b-buckley/blinker-vest/images/enclosure/tinkercad/box-design_1_negative-volume_th.png

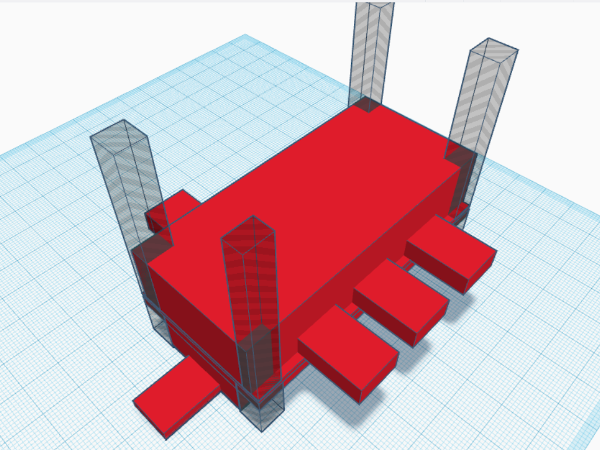
images/enclosure/tinkercad/box-design_1_negative-volume_th.png
