b-buckley/blinker-vest/images/enclosure/box-2_resizing-fuse-holes_th.jpg

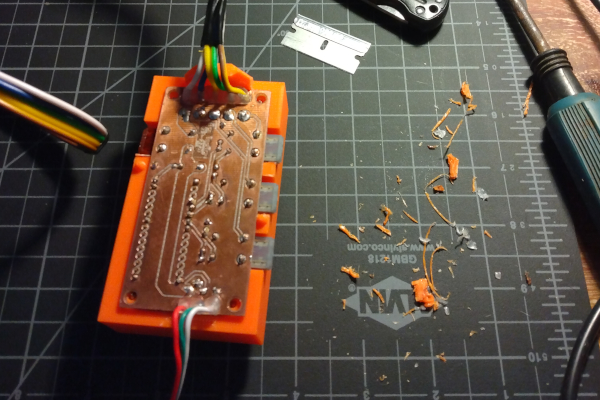
images/enclosure/box-2_resizing-fuse-holes_th.jpg
