b-buckley/blinker-vest/images/enclosure/box-4_finished-bottom_th.jpg

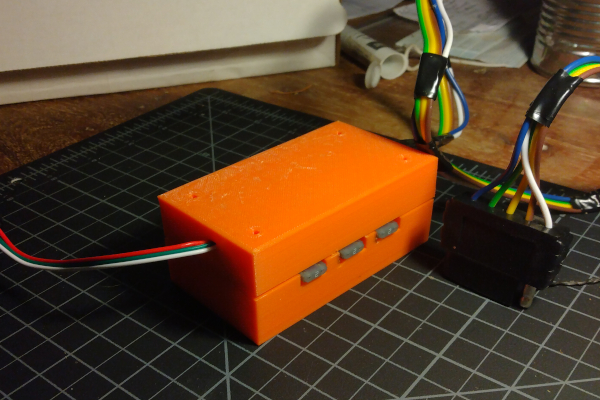
images/enclosure/box-4_finished-bottom_th.jpg
