b-buckley/blinker-vest/images/enclosure/box-5_finished-top_screw-holes_th.jpg

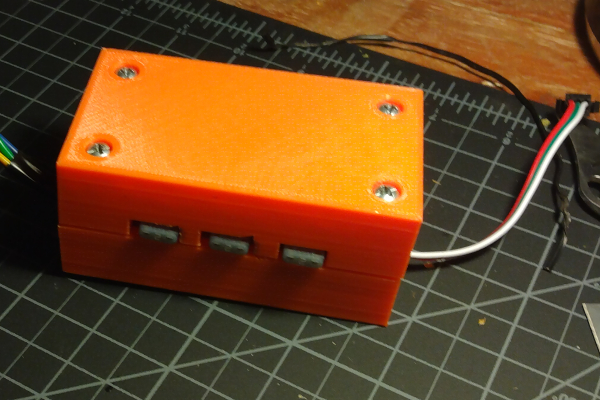
images/enclosure/box-5_finished-top_screw-holes_th.jpg
