b-buckley/blinker-vest/images/enclosure/tinkercad/box-design_2_solid-box.png

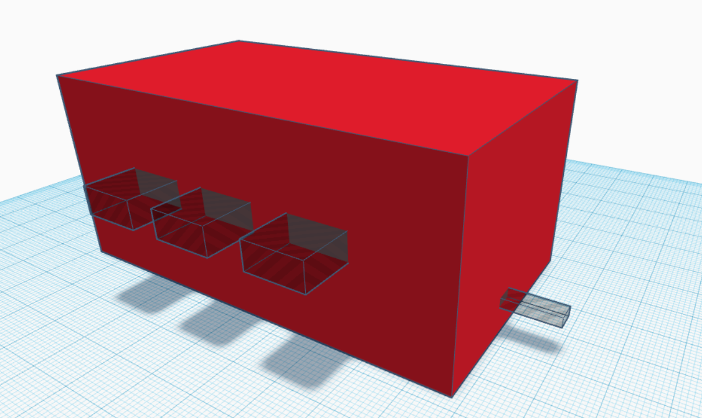
images/enclosure/tinkercad/box-design_2_solid-box.png
