b-buckley/blinker-vest/images/enclosure/tinkercad/box-design_3_tabs-cut-out.png

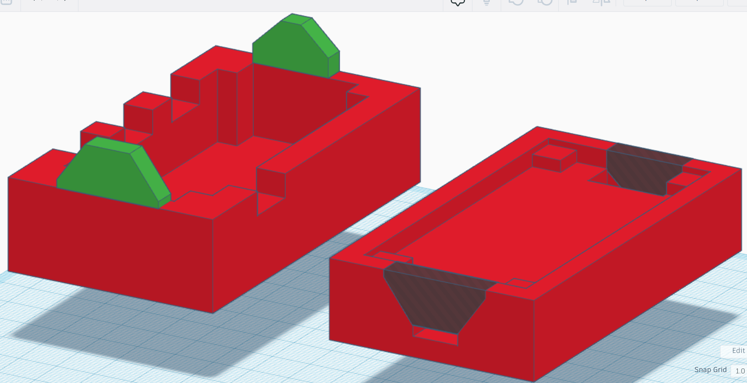
images/enclosure/tinkercad/box-design_3_tabs-cut-out.png
