b-buckley/blinker-vest/images/enclosure/tinkercad/box-design_4_teeth-and-pips.png

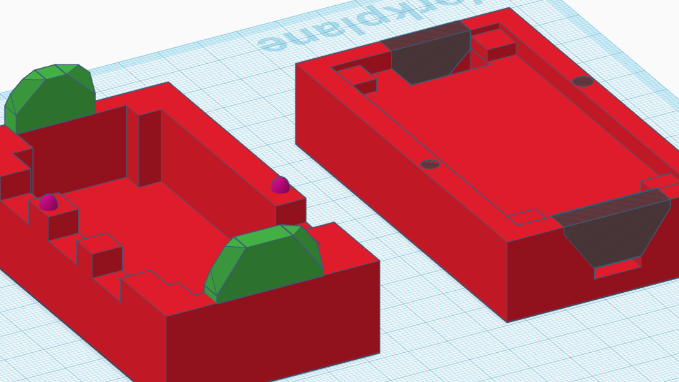
images/enclosure/tinkercad/box-design_4_teeth-and-pips.png
