b-buckley/blinker-vest/images/enclosure/tinkercad/box-design_5_screw-holes.png

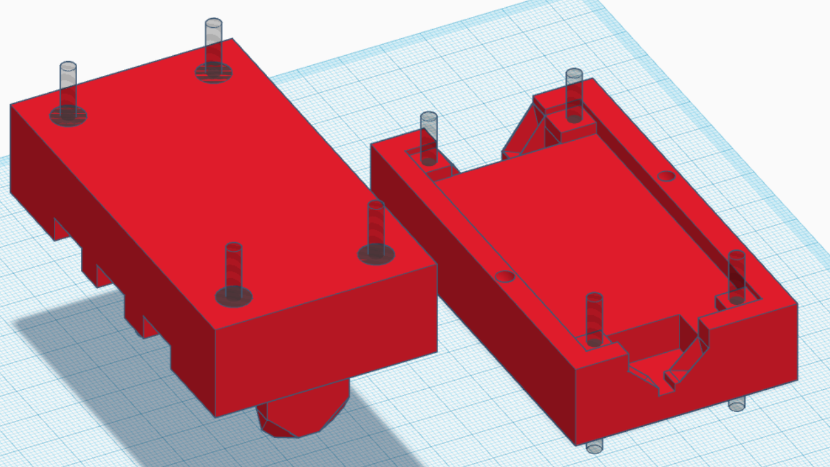
images/enclosure/tinkercad/box-design_5_screw-holes.png
