b-buckley/blinker-vest/images/GvMz.gif

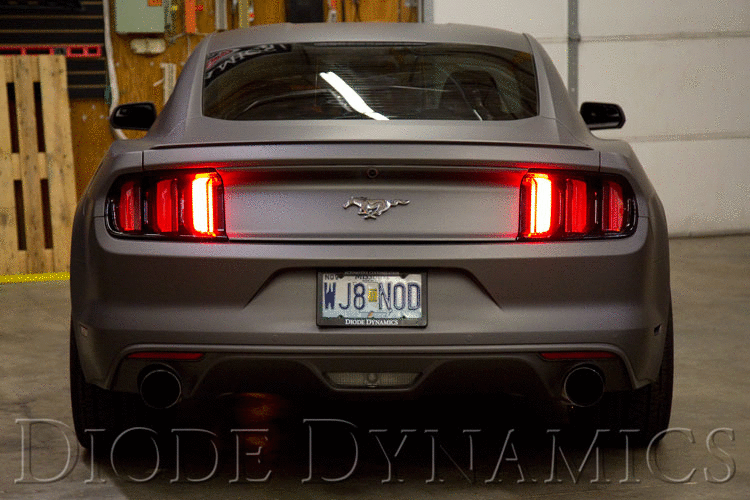
images/GvMz.gif
