b-buckley/blinker-vest/images/pcb-schematic_final.png

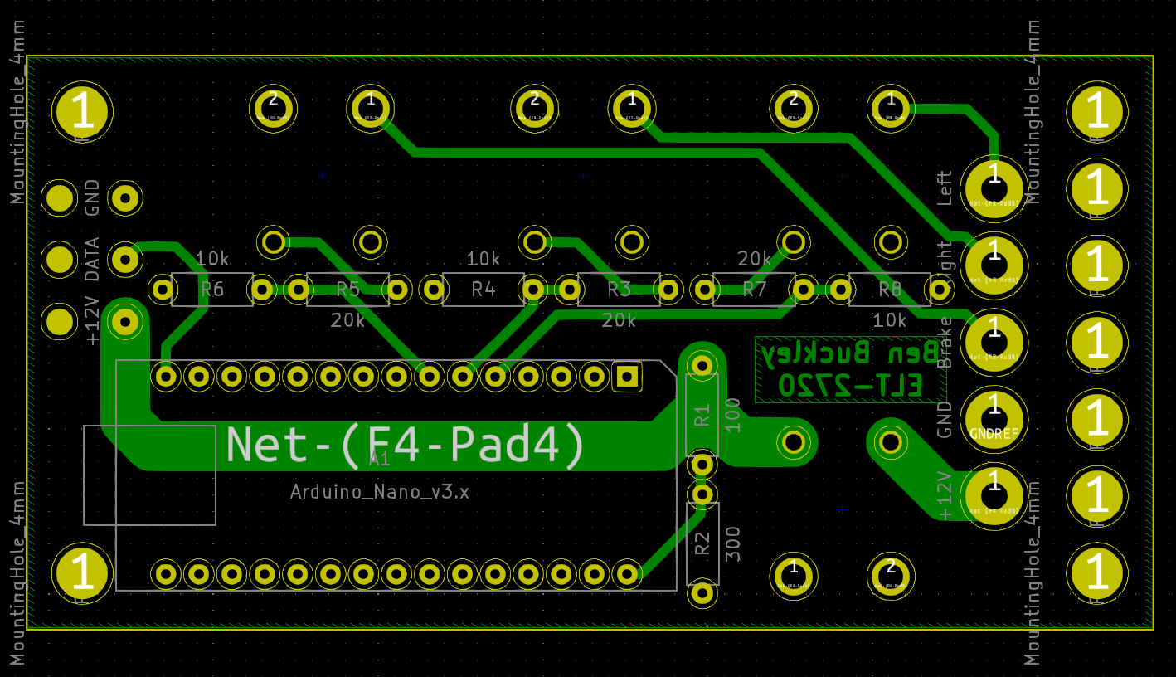
images/pcb-schematic_final.png
