b-buckley/blinker-vest/images/prototype_high-signal.jpg

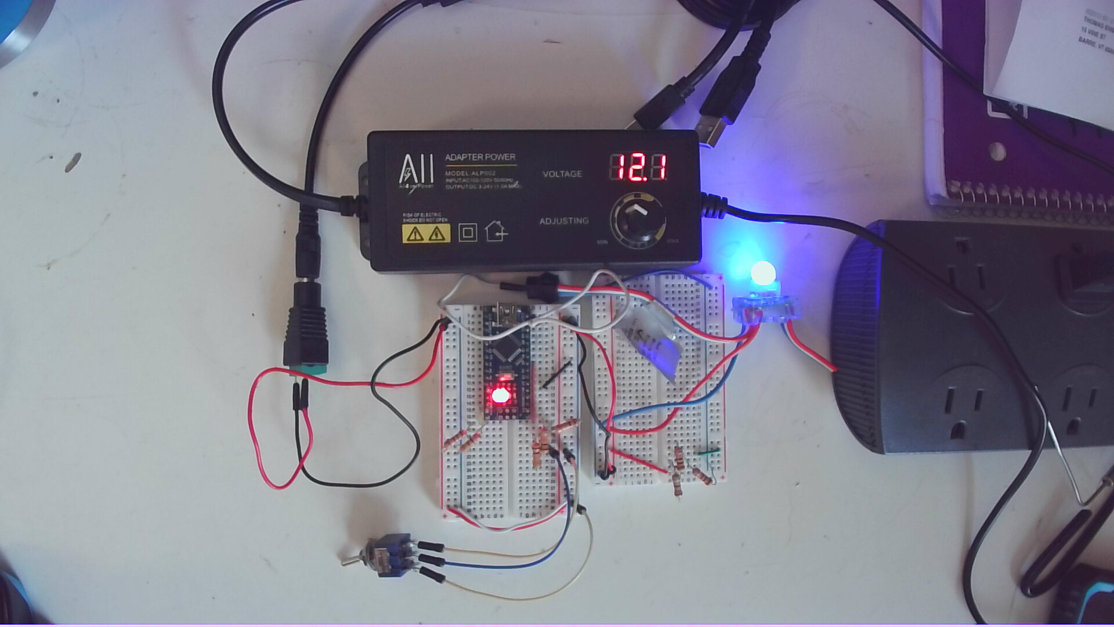
images/prototype_high-signal.jpg
