b-buckley/blinker-vest/kicad/schematic_0.0.1_first-draft_.jpg

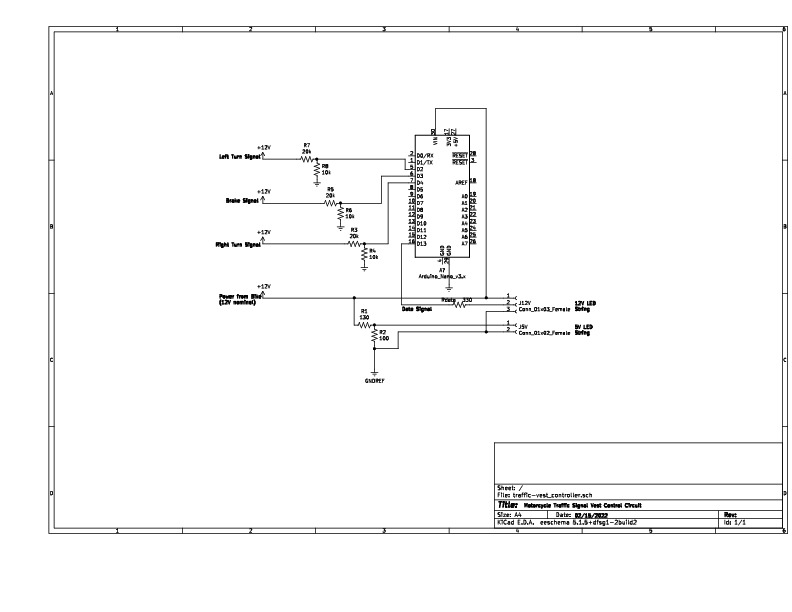
kicad/schematic_0.0.1_first-draft_.jpg
