b-buckley/blinker-vest/reports/blinker-vest_block-diagram_v.1.png

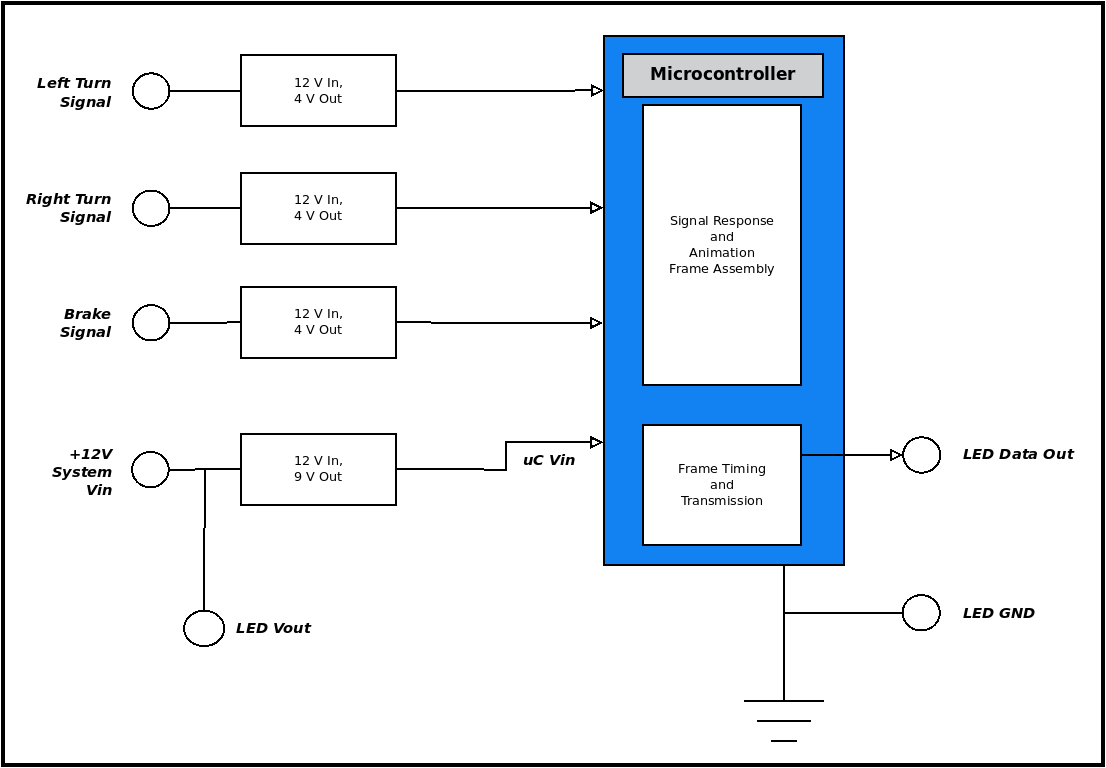
reports/blinker-vest_block-diagram_v.1.png
