b-buckley/blinker-vest/reports/firmware-state-diagram_v0.1.png

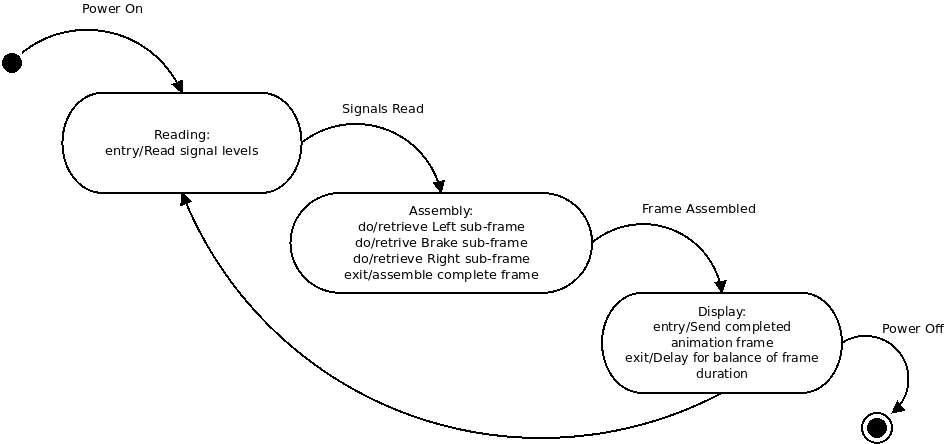
reports/firmware-state-diagram_v0.1.png
