b-buckley/blinker-vest/reports/firmware-state-diagram_v0.2.png

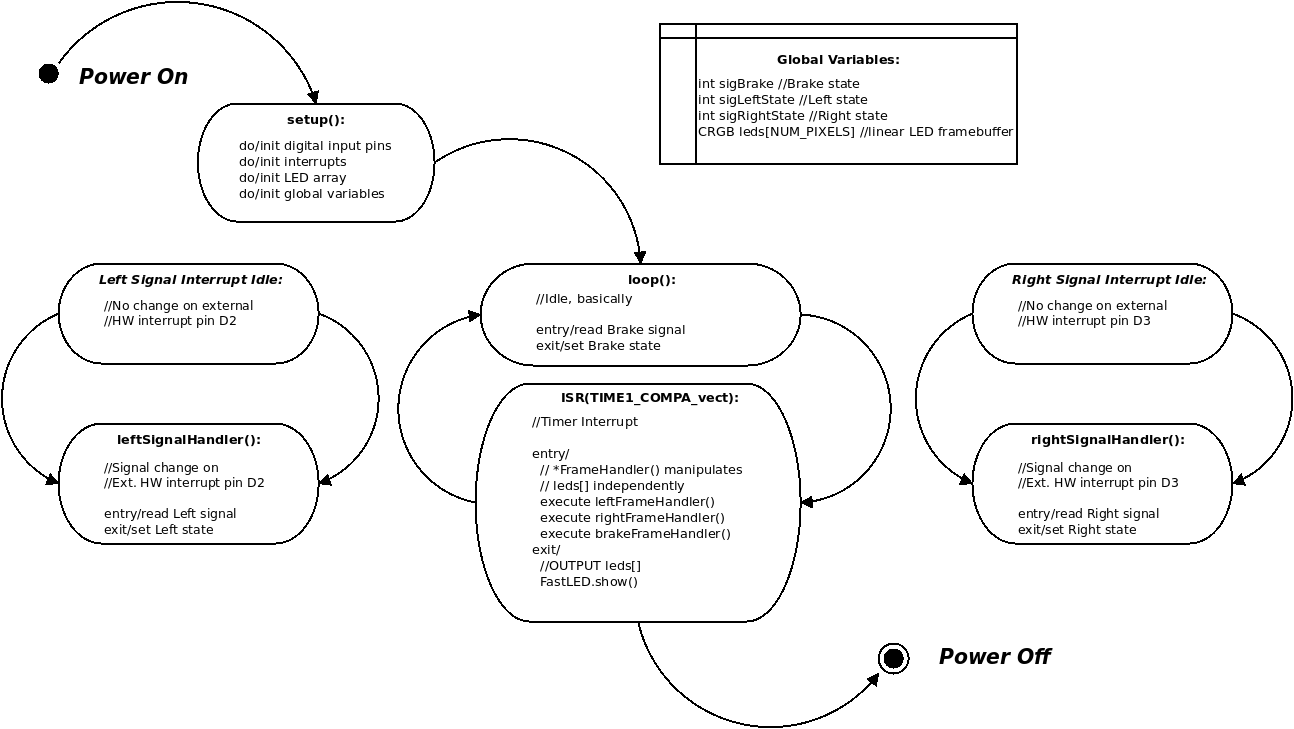
reports/firmware-state-diagram_v0.2.png
