b-buckley/blinker-vest/tinkercad/Blinker Vest Controller Enclosure -- Prepped for Export and Slicing.stl

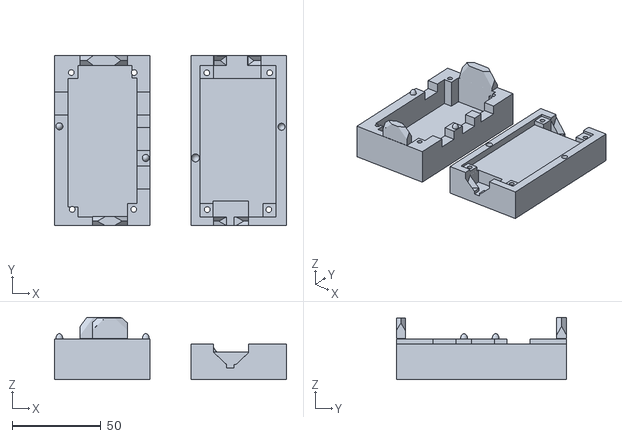
[picture p32: CAD file, 2022-05-07]
tinkercad/Blinker Vest Controller Enclosure -- Prepped for Export and Slicing.stl
131.0 x 96.0 x 35.0
