b-buckley/blinker-vest/images/enclosure/box-1_fitting-and-repairs_th.jpg

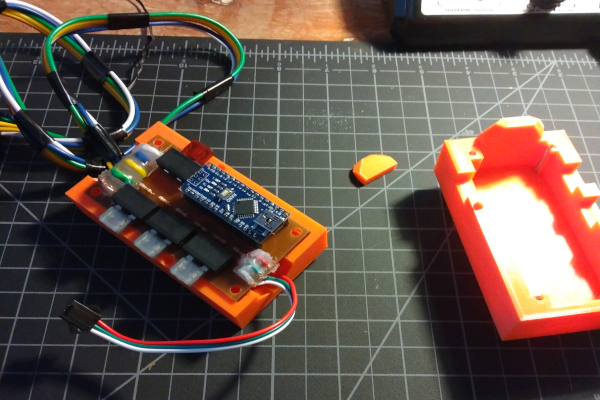
images/enclosure/box-1_fitting-and-repairs_th.jpg
