b-buckley/blinker-vest/kicad/schematic_0.0.1_first-draft_.pdf

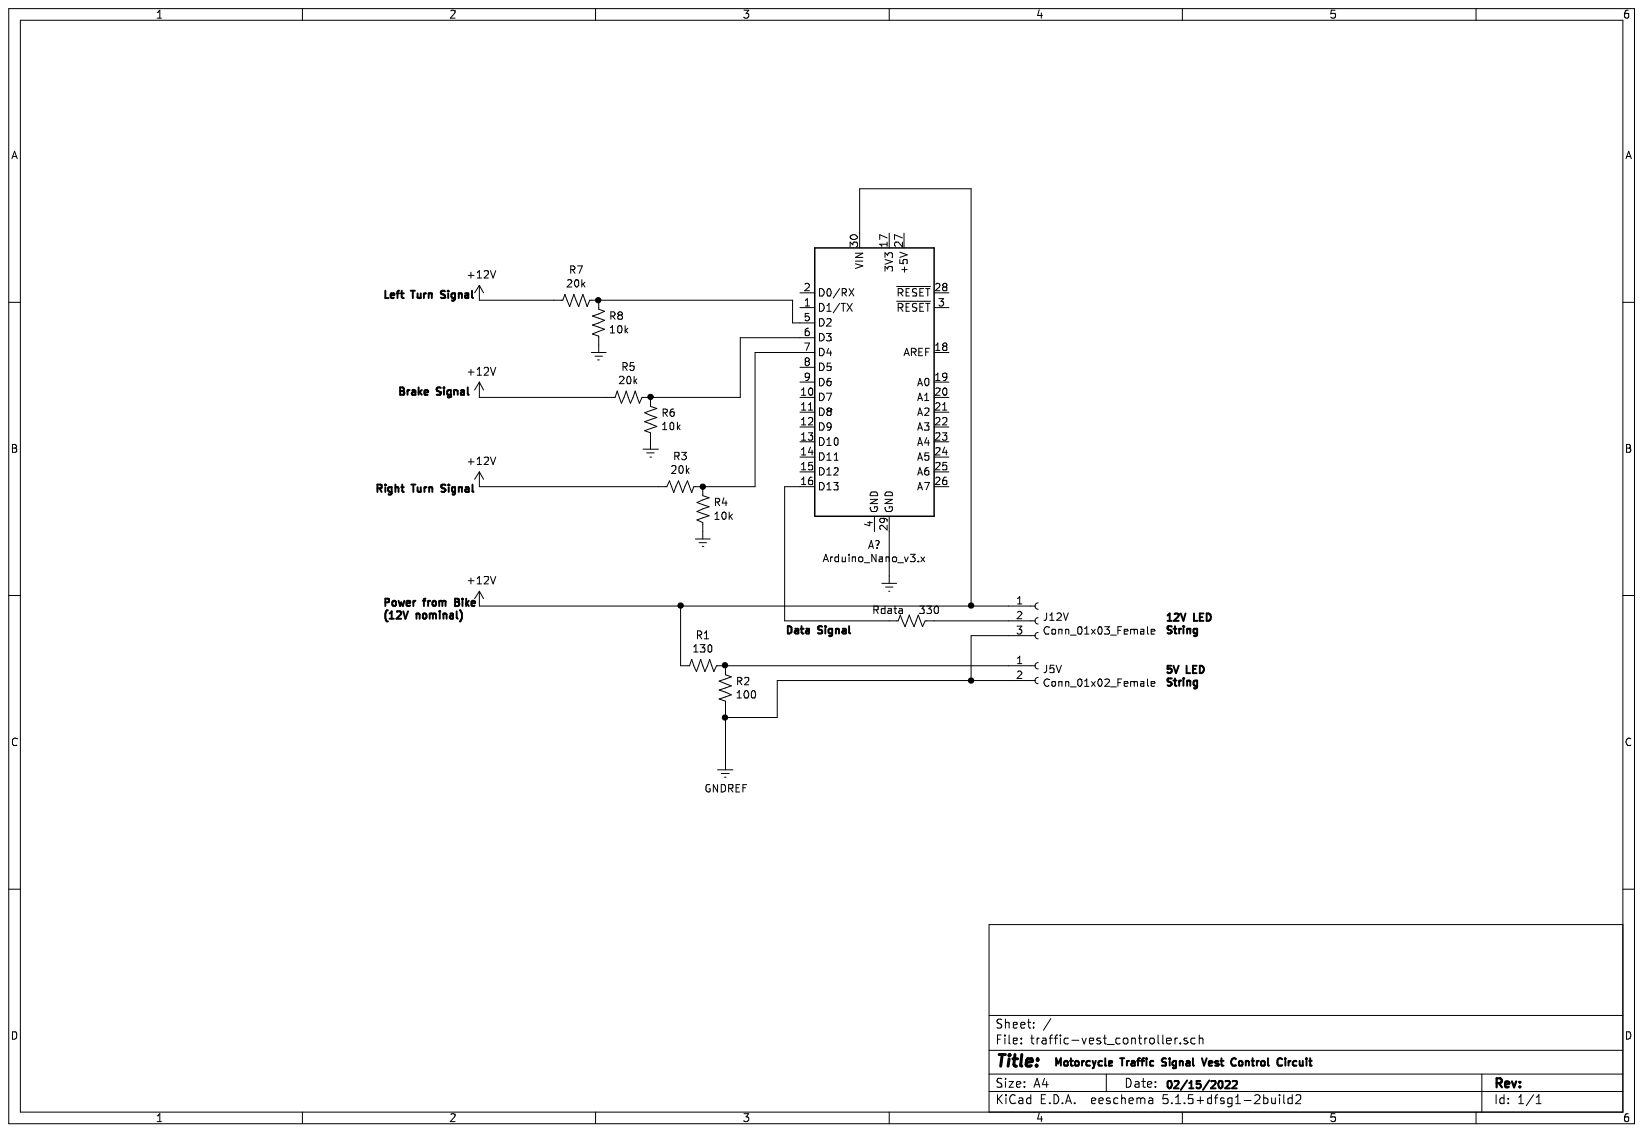
[picture p35: page 1]
