b-buckley/blinker-vest/kicad/traffic-vest_controller/traffic-vest_controller.sch

## KiCad design kicad/traffic-vest_controller/traffic-vest_controller.sch (2022-04-07)

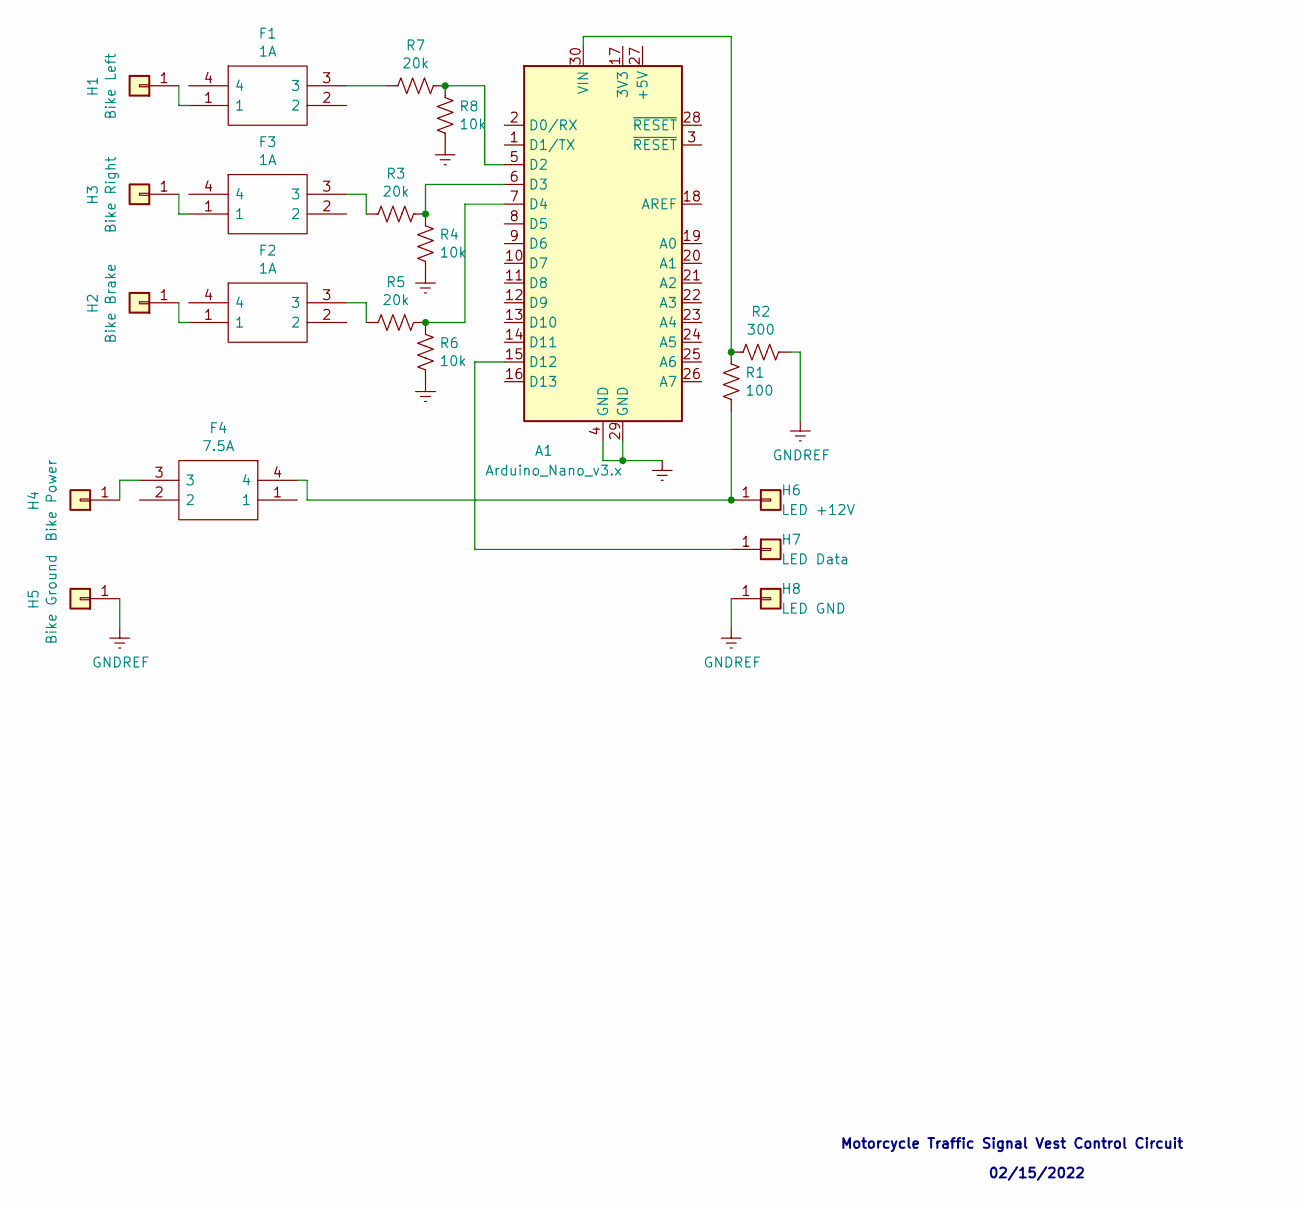
[picture p36: schematic traffic-vest_controller.sch]

Parts:
A1: Arduino_Nano_v3.x; Arduino_Nano
F1, F2, F3: 1A; 35492; Mouser Part Number 534-3549-2
F4: 7.5A; 35492; Mouser Part Number 534-3549-2
H1: Bike Left; SolderWirePad_1x01_Drill2mm
H2: Bike Brake; SolderWirePad_1x01_Drill2mm
H3: Bike Right; SolderWirePad_1x01_Drill2mm
H4: Bike Power; SolderWirePad_1x01_Drill2mm
H5: Bike Ground; SolderWirePad_1x01_Drill2mm
H6: LED +12V; SolderWirePad_1x01_Drill0.8mm
H7: LED Data; SolderWirePad_1x01_Drill0.8mm
H8: LED GND; SolderWirePad_1x01_Drill0.8mm
R1: 100; R_Axial_DIN0207_L6.3mm_D2.5mm_P7.62mm_Horizontal
R2: 300; R_Axial_DIN0207_L6.3mm_D2.5mm_P7.62mm_Horizontal
R3, R5, R7: 20k; R_Axial_DIN0207_L6.3mm_D2.5mm_P7.62mm_Horizontal
R4, R6, R8: 10k; R_Axial_DIN0207_L6.3mm_D2.5mm_P7.62mm_Horizontal

Connections:
GNDREF: A1.4 (GND), A1.29 (GND), H5.1, H8.1, R2.1, R4.2, R6.2, R8.2
unnamed: A1.5 (D2), R7.1, R8.1
unnamed: A1.6 (D3), R3.1, R4.1
unnamed: A1.7 (D4), R5.1, R6.1
unnamed: A1.15 (D12), H7.1
unnamed: A1.30 (VIN), R1.1, R2.2
unnamed: F1.1, H1.1
unnamed: F1.3, R7.2
unnamed: F2.1, H2.1
unnamed: F2.3, R5.2
unnamed: F3.1, H3.1
unnamed: F3.3, R3.2
unnamed: F4.3, H4.1
unnamed: F4.4, H6.1, R1.2

Notes on the sheet:
Motorcycle Traffic Signal Vest Control Circuit
02/15/2022
