b-buckley/blinker-vest/(commit log)

2022-03-09 Better late than never to start version tracking and stop sweating about version numbers
    [3549-2.stl, 3549-2.stp, 35492.psm, EDI2CAP.CFG, chips.prt]
2022-03-10 Converted physical connectors to mounting holes; need to resize holes in PCB for wire sizes and spacing
2022-03-15 first add of schematics b/c of cached submodule weirdness. Includes updates as of converting connectors/mounting holes to generic pins with THT solder holes and matching strain-relief NPTHs. Also rea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
    [traffic-vest_controller.kicad_pcb, traffic-vest_controller.sch]
2022-03-16 expanded board footprint to accomodate corner mounting holes; rearranged fuses and pins for left/right to D2, D3 for external interrupts; fixed orientation of fuse clips
    [traffic-vest_controller.kicad_pcb, traffic-vest_controller.sch]
2022-03-16 Routed tracks and added ground pour. Potentially finished PCB layout!
    [traffic-vest_controller.kicad_pcb]
2022-03-16 Minor track tweaks
    [traffic-vest_controller.kicad_pcb]
2022-03-16 More minor track tweaks
    [traffic-vest_controller.kicad_pcb]
2022-03-17 moved copper to back of PCB, flipped fuse clips, rerouted tracks, refilled copper pour
    [traffic-vest_controller.kicad_pcb, traffic-vest_controller.sch]
2022-03-24 Flipped nano, rearranged digital pin connecctions, futzed with connection spacing, re-routed tracks
    [traffic-vest_controller.kicad_pcb, traffic-vest_controller.sch]
2022-03-24 Began writing firmware in earnest: Brake output runs on a timer interrupt, turn signals on hardware interrupts. Need to finish implementing overall flow.
2022-03-29 Fixed ground pour to make contiguous zone. One more rearrangement of circuits to pins for cleanliness and short tracks. Generated gerbers and drill file for cutting.
    [traffic-vest_controller.kicad_pcb, traffic-vest_controller.sch]
2022-03-29 Isolated (left) animation within leftFrameHandler(). Timer set-up is now calculated from FREQUENCY macro instead of hard-coded.
2022-04-07 Board V3, child of V1: \n* Corrected orientation of nano\n* Re-ran tracks\n* Incorporated V2 improvements: wire drill hole sizes, extra spacing between mount and relief holes, name and course etched 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
    [traffic-vest_controller.kicad_pcb, traffic-vest_controller.sch]
2022-04-23 Added ./site for project website
    [traffic-vest_controller-B_Cu.gbr, traffic-vest_controller-B_Mask.gbr, traffic-vest_controller-Edge_Cuts.gbr, traffic-vest_controller.drl]
2022-04-23 clean up on main
    [traffic-vest_controller.kicad_pcb, traffic-vest_controller.sch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]
2022-04-23 more cleanup
    [traffic-vest_controller-Edge_Cuts.gbr]
2022-05-07 added board process images
    [Blinker Vest Controller Enclosure -- Prepped for Export and Slicing.stl]
2022-05-07 added board design images
