b-buckley/blinker-vest/images/enclosure/box-2_resizing-fuse-holes.jpg

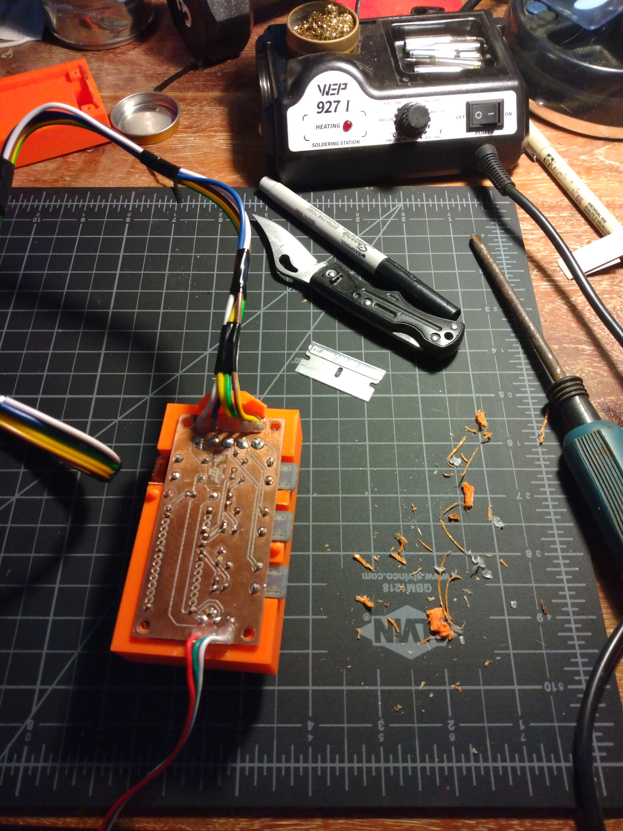
images/enclosure/box-2_resizing-fuse-holes.jpg
