b-buckley/blinker-vest/images/enclosure/box-4_finished-bottom.jpg

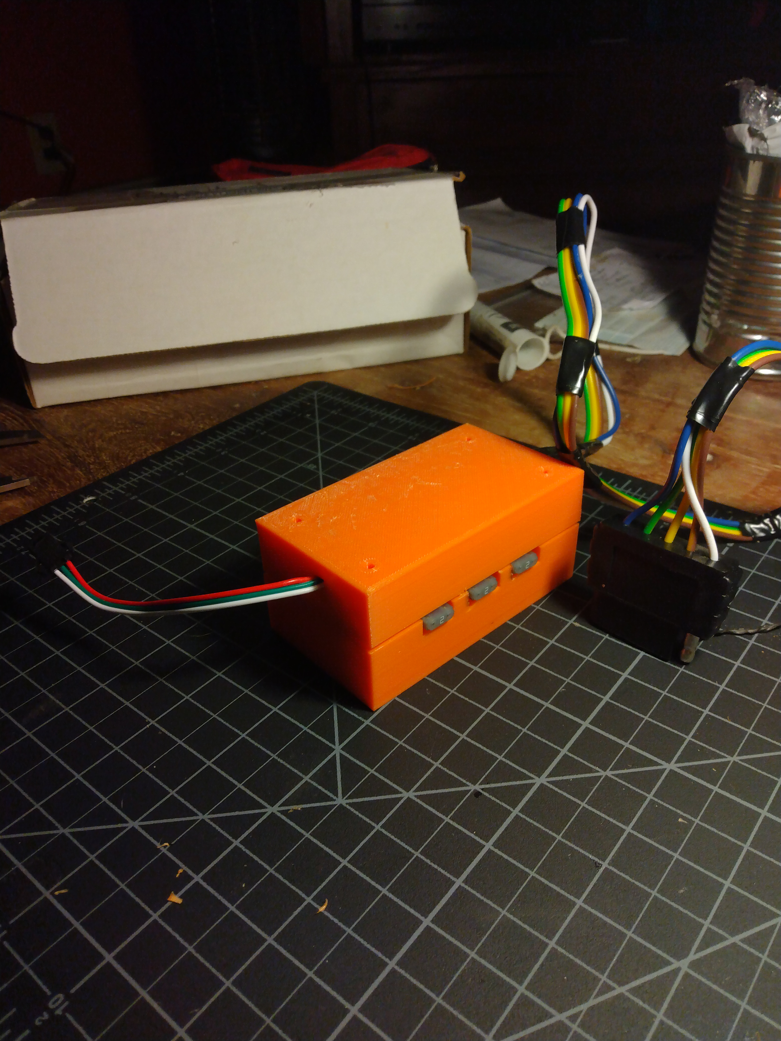
images/enclosure/box-4_finished-bottom.jpg
