b-buckley/blinker-vest/images/enclosure/box-3_widened-board-area_repaired-top.jpg

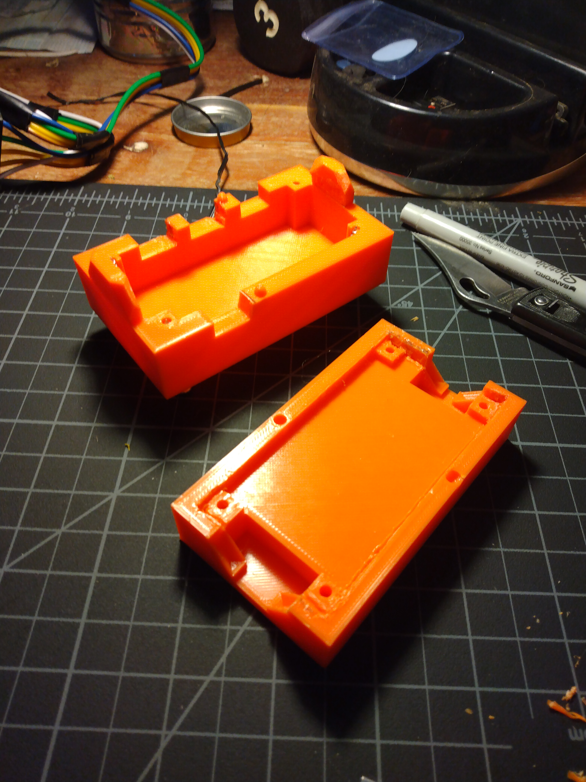
images/enclosure/box-3_widened-board-area_repaired-top.jpg
